AShayem/BGR_NSL_FINAL/Simulation and Validation Document_Bandgap_Reference_BGR_v2.pdf

# Bandgap Reference (BGR)

# Team Members:

## Md Abu Shayem, Engineer II Faruk Al-Amin, Engineer I Fahim Tawfiq Khan, Engineer I Ebadur Rahman Khan, Team Lead

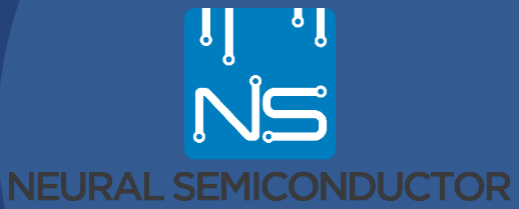
[picture p5: figure]

## Md. Shafiul Huda Eraz, Sr. Engineer

Analog Design, Neural Semiconductor Limited.

Bandgap Reference (BGR) | Md Abu Shayem | 2

# Design Specification

Parameter | Specification
VDD, VSS | 1.8V, 0V
Vref | 1.0V
Temp. Coefficient(Tc) | <30ppm/℃
Power | <200uW
Input Pin | 2
Output Pin | 1

Table 1: Design specification of the bandgap reference

# TB_BGR_Top

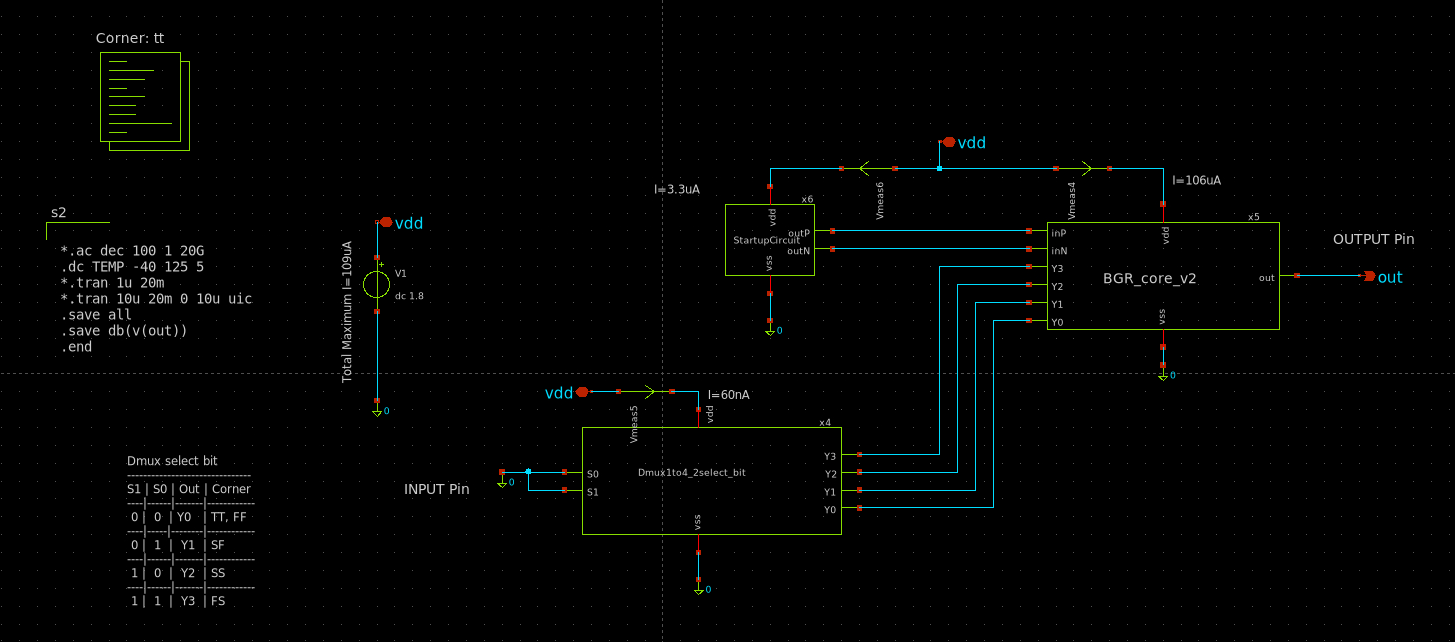
[picture p6: figure]

Figure 1: Block-level top testbench (TB_BGR_Top)

# TB_BGR_Top

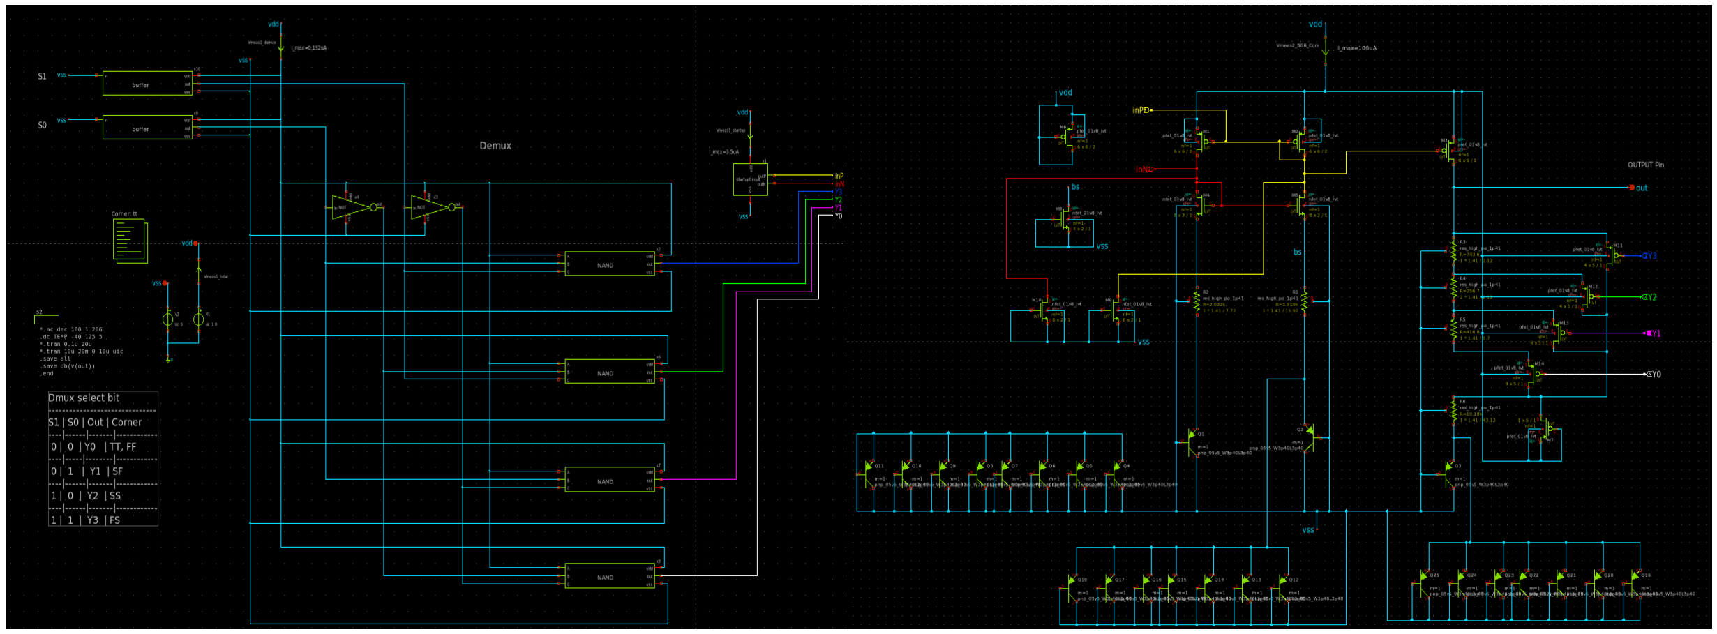
[picture p7: figure]

Note: Block level Testbench shows different Temperature coefficient (TC) result so another TB is created by making BGR core in device level.

Figure 2: Device-level top testbench (TB_BGR_Top) with the BGR core built from primitive devices

# Startup Circuit

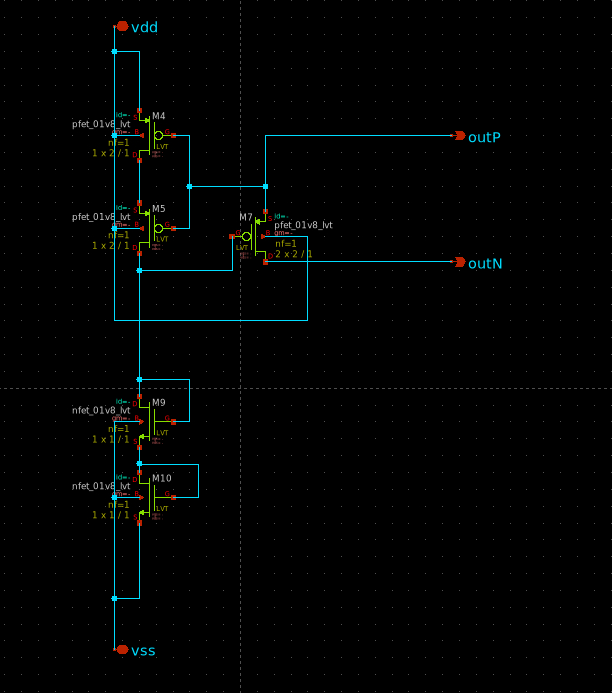
[picture p8: figure]

Figure 3: Startup circuit schematic

# BGR Core and Vref Branch

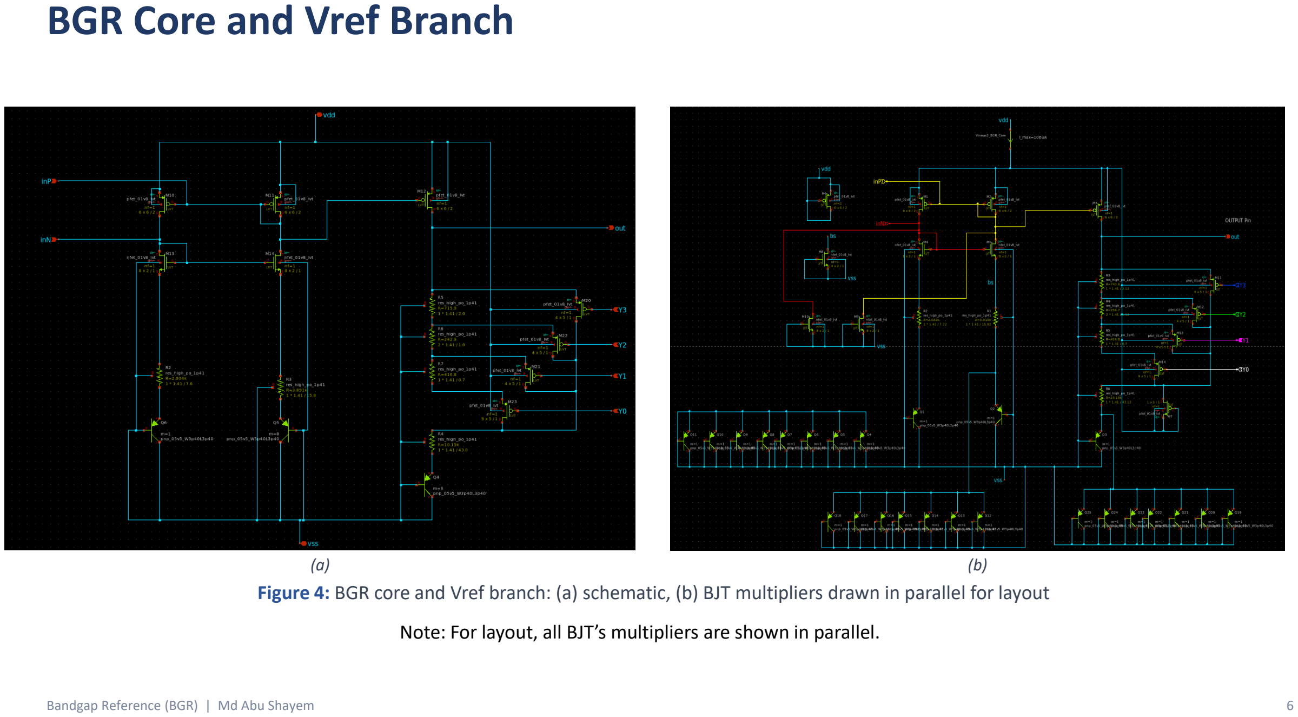
[picture p9: page 6]

Note: For layout, all BJT’s multipliers are shown in parallel.

(a) (b)
Figure 4: BGR core and Vref branch: (a) schematic, (b) BJT multipliers drawn in parallel for layout

# Dmux Schematic

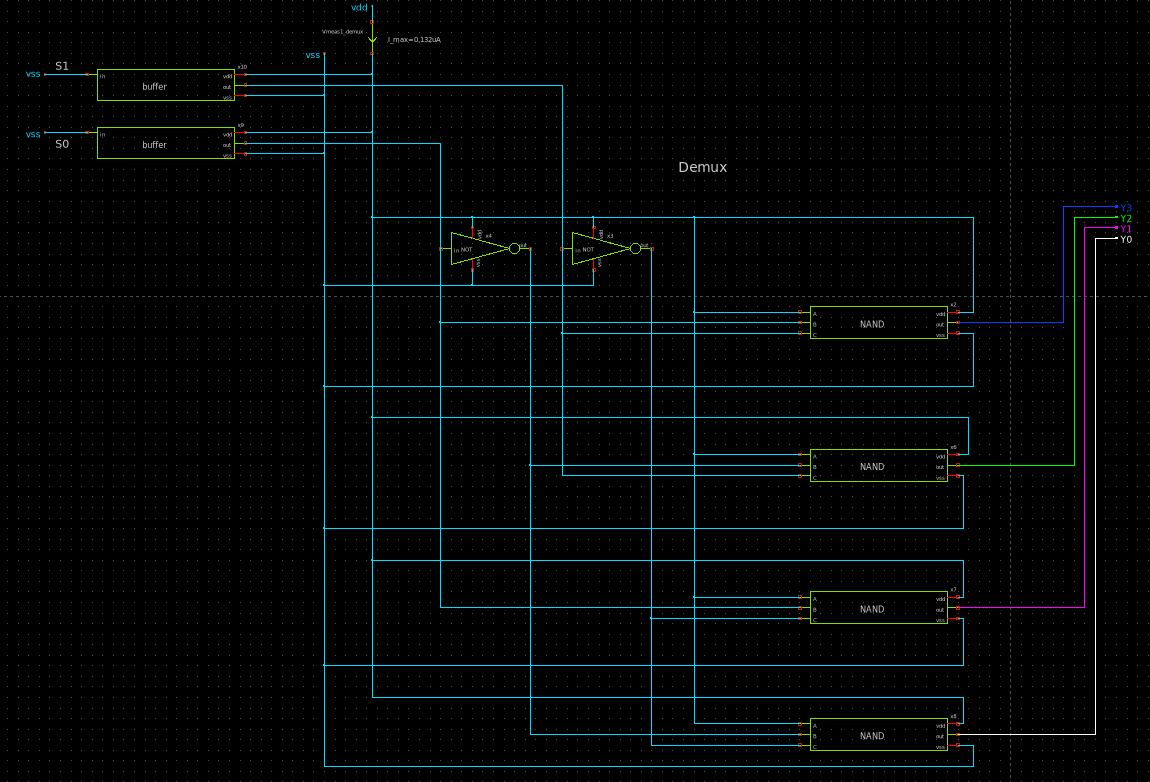
[picture p10: figure]

Figure 5: Dmux schematic

# Dmux select bit

S1 | S0 | Y3 | Y2 | Y1 | Y0 | Corner
0 | 0 | 1 | 1 | 1 | 0 | TT, FF
0 | 1 | 1 | 1 | 0 | 1 | SF
1 | 0 | 1 | 0 | 1 | 1 | SS
1 | 1 | 0 | 1 | 1 | 1 | FS

Table 2: Dmux select-bit settings and the corresponding process corners

# Corner: TT

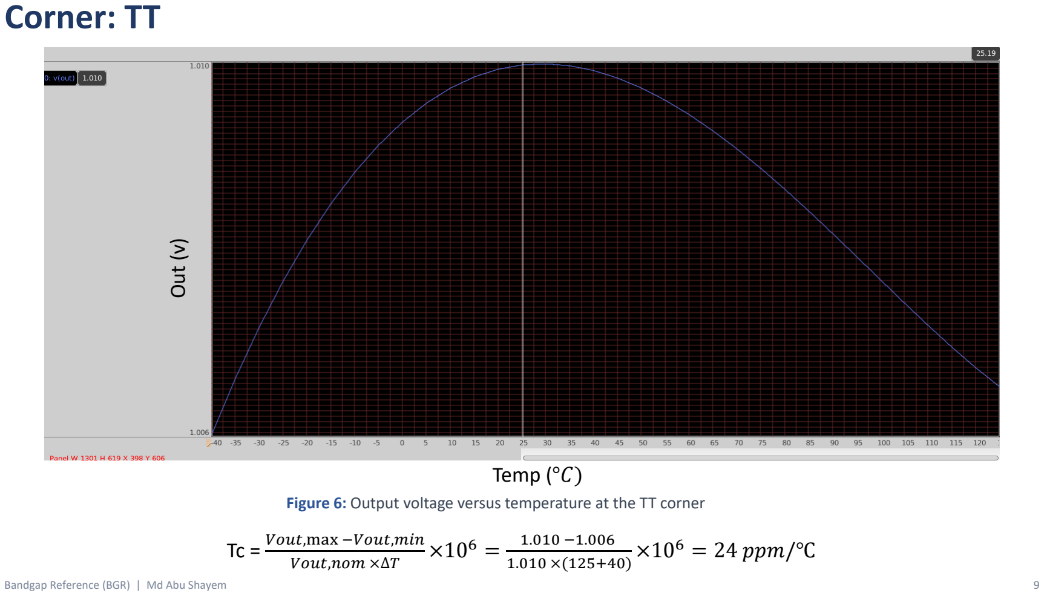
[picture p11: page 9]

### Out (v)

### Temp (°C)

Tc = Vout,max −Vout,min
Vout,nom ×∆T

×10⁶ =

1.010 −1.006
1.010 ×(125+40)

### ×10⁶ = 24 ppm/℃

Figure 6: Output voltage versus temperature at the TT corner

# Corner: FF

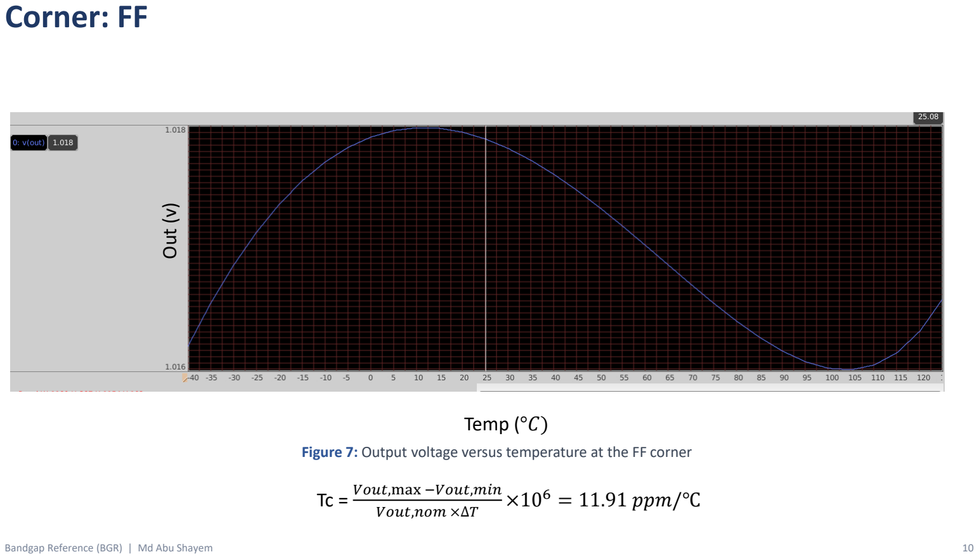
[picture p12: page 10]

### Out (v)

### Temp (°C)

Tc = Vout,max −Vout,min
Vout,nom ×∆T

### ×10⁶ = 11.91 ppm/℃

Figure 7: Output voltage versus temperature at the FF corner

# Corner: FS

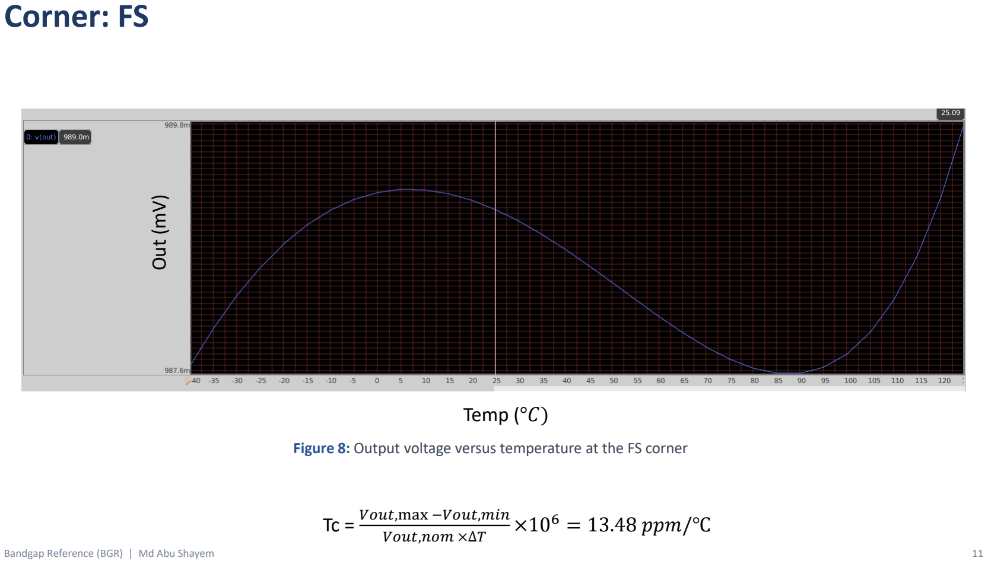
[picture p13: page 11]

### Out (mV)

### Temp (°C)

Tc = Vout,max −Vout,min
Vout,nom ×∆T

### ×10⁶ = 13.48 ppm/℃

Figure 8: Output voltage versus temperature at the FS corner

# Corner: SF

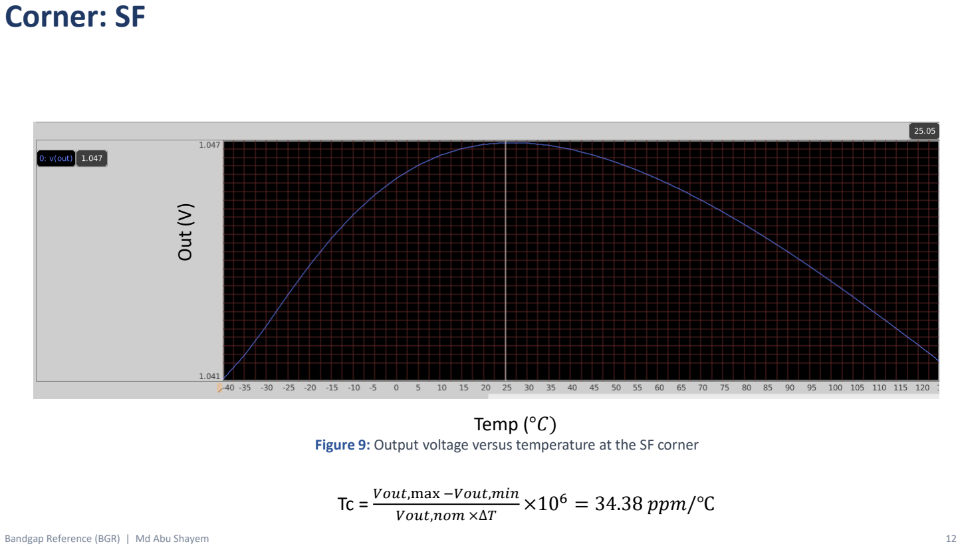
[picture p14: page 12]

### Out (V)

### Temp (°C)

Tc = Vout,max −Vout,min
Vout,nom ×∆T

### ×10⁶ = 34.38 ppm/℃

Figure 9: Output voltage versus temperature at the SF corner

# Corner: SS

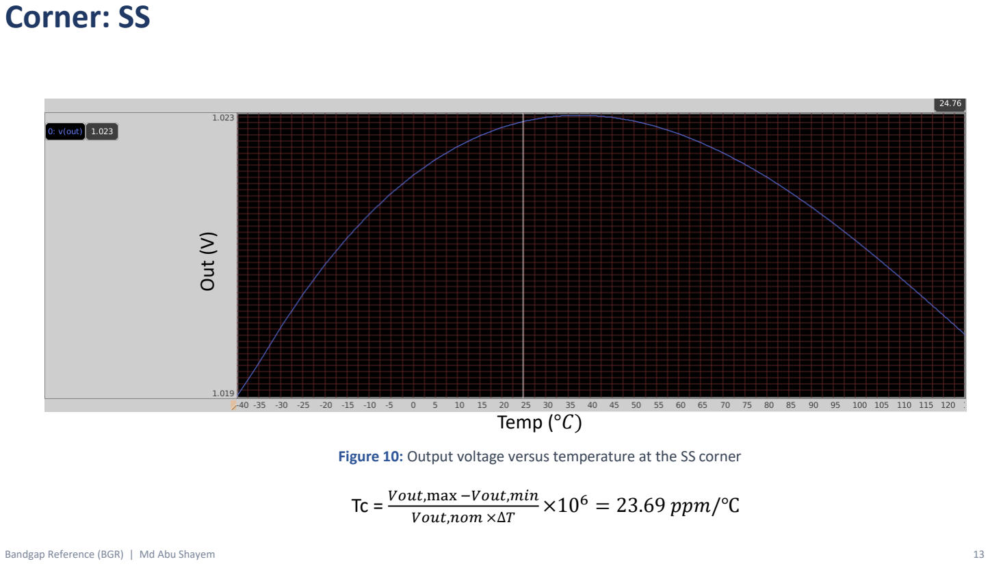
[picture p15: page 13]

### Out (V)

### Temp (°C)

Tc = Vout,max −Vout,min
Vout,nom ×∆T

### ×10⁶ = 23.69 ppm/℃

Figure 10: Output voltage versus temperature at the SS corner

# TB_Stability

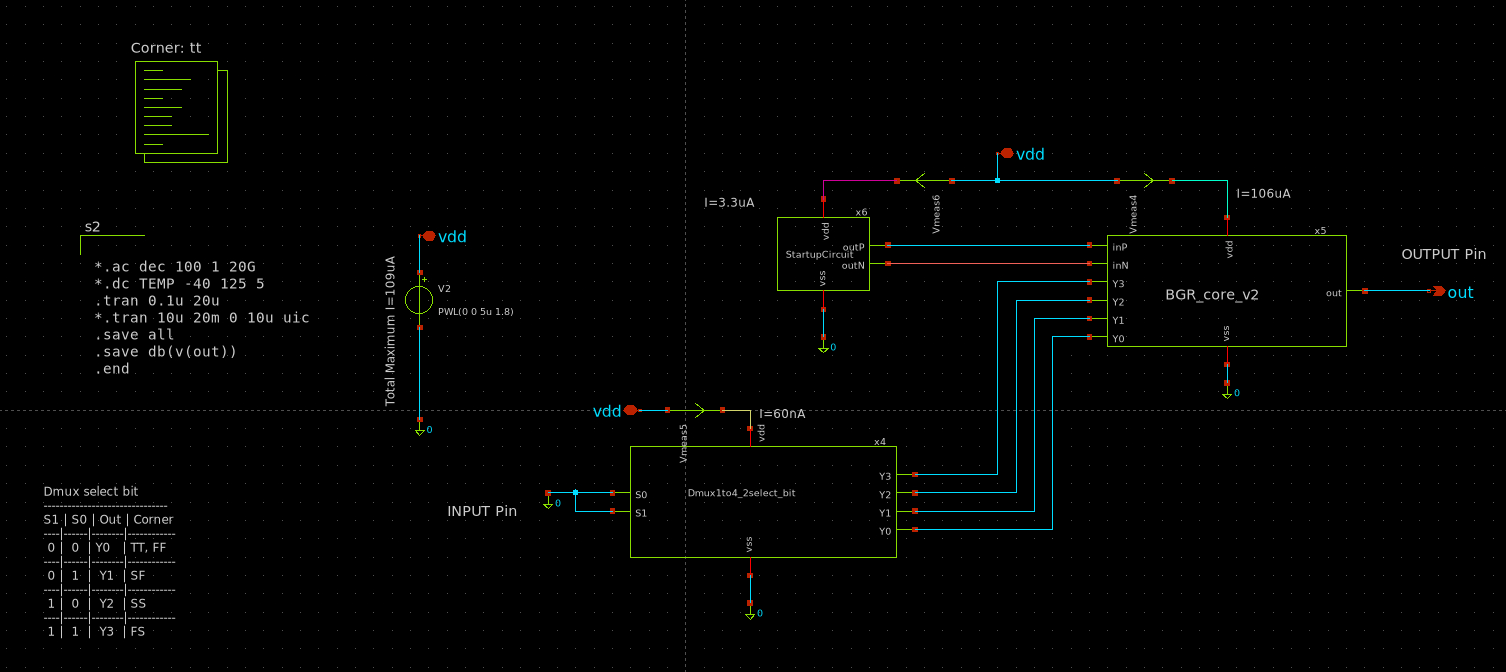
[picture p16: figure]

Figure 11: Stability testbench (TB_Stability)

# Stability_5us Ramp

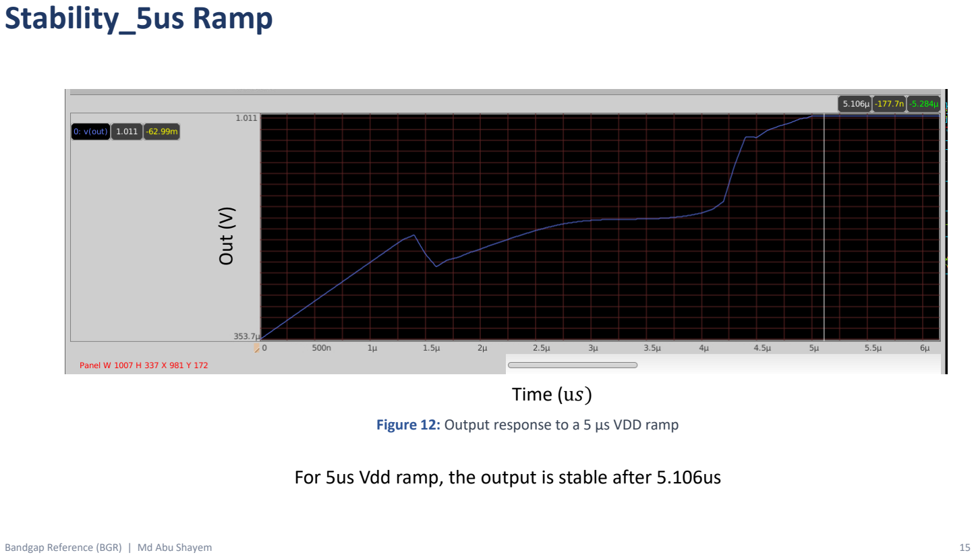
[picture p17: page 15]

### For 5us Vdd ramp, the output is stable after 5.106us

Figure 12: Output response to a 5 µs VDD ramp

### Out (V)

### Time (us)

# Stability_1us Ramp

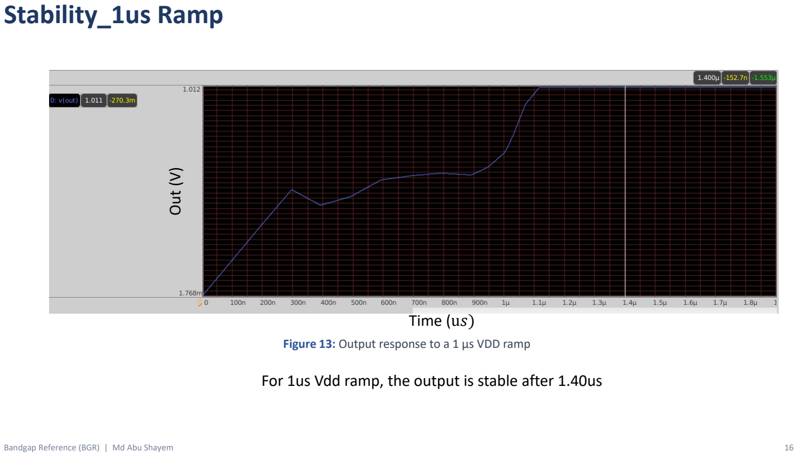
[picture p18: page 16]

### For 1us Vdd ramp, the output is stable after 1.40us

### Out (V)

### Time (us)

Figure 13: Output response to a 1 µs VDD ramp

# TB_PSRR

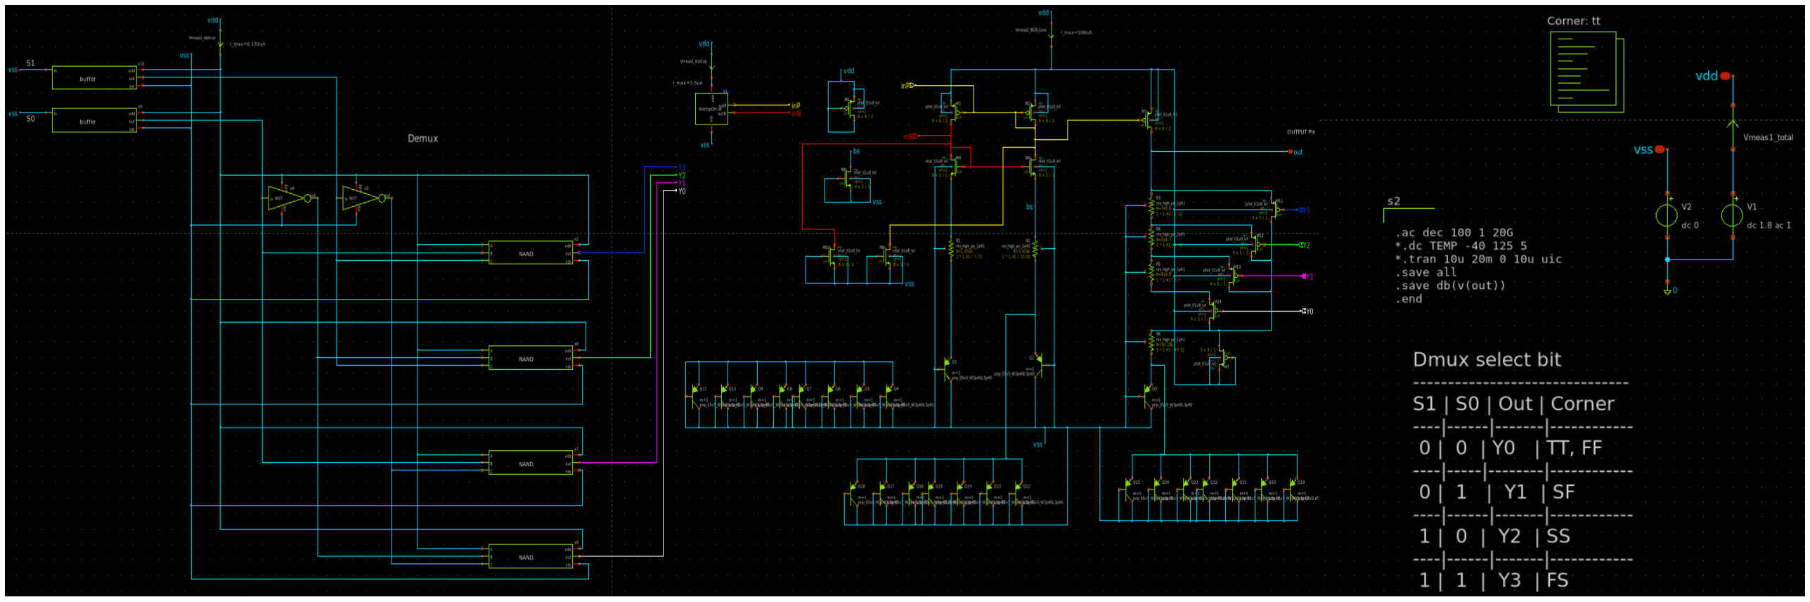
[picture p19: figure]

Figure 14: PSRR testbench (TB_PSRR)

# PSRR

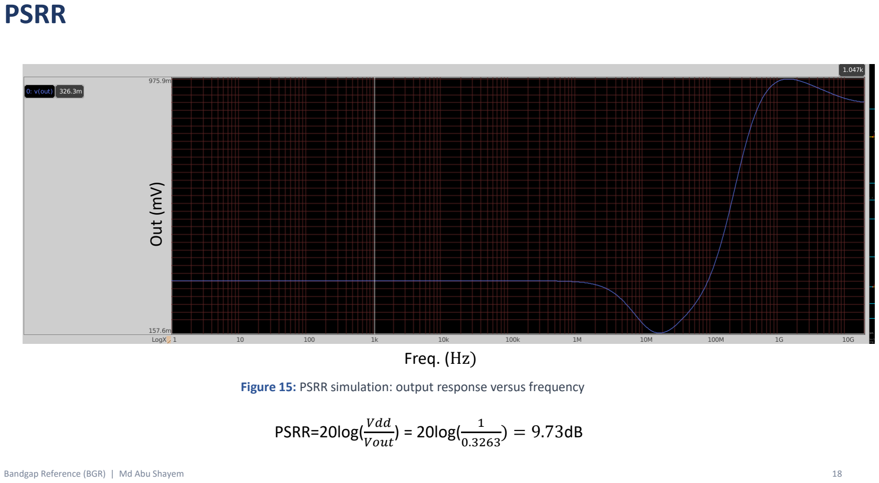
[picture p20: page 18]

### PSRR=20log( Vdd

Vout

### ) = 20log( 1

0.3263

) = 9.73dB

Figure 15: PSRR simulation: output response versus frequency

### Out (mV)

### Freq. (Hz)

# Key Results at Different Corners

Corner | Schematic | Post-layout (PEX)
(ppm/°C) Tc | Trim R6 (Ω) | Vout @ 27°C (V) | Power (µW) | S1 (V) | S0 (V) | Tc (ppm/°C) | Vout @ 27°C (V) | PSRR @ 1 kHz (dB) | Power (µW)
TT | 24 | 11.526k | 1.010 | 192.96 | 1.8 | 0 | 26.6 | 1.0213 | 9.47 | 193.72
FF | 11.91 | 11.526k | 1.018 | 198.36 | 1.8 | 0 | 21.4 | 1.0241 | 9.54 | 199.89
SS | 23.69 | 10.866k | 1.023 | 187.56 | 1.8 | 0 | 32.5 | 1.0185 | 8.99 | 188.11
FS | 13.48 | 10.18k | 0.9890 | 197.28 | 1.8 | 1.8 | 25.3 | 0.9887 | 7.66 | 199.20
SF | 34.73 | 11.109k | 0.9985 | 188.82 | 0 | 1.8 | 25.3 | 1.0407 | 11.19 | 189.57

R6_trim base is 10.18 kΩ; Rds of each switch MOS is added in series with each selection. S1/S0: 1.8 V = logic 1, 0 V = logic 0.

Table 3: Key results at different corners: schematic vs. post-layout (PEX)

# LVS Verification

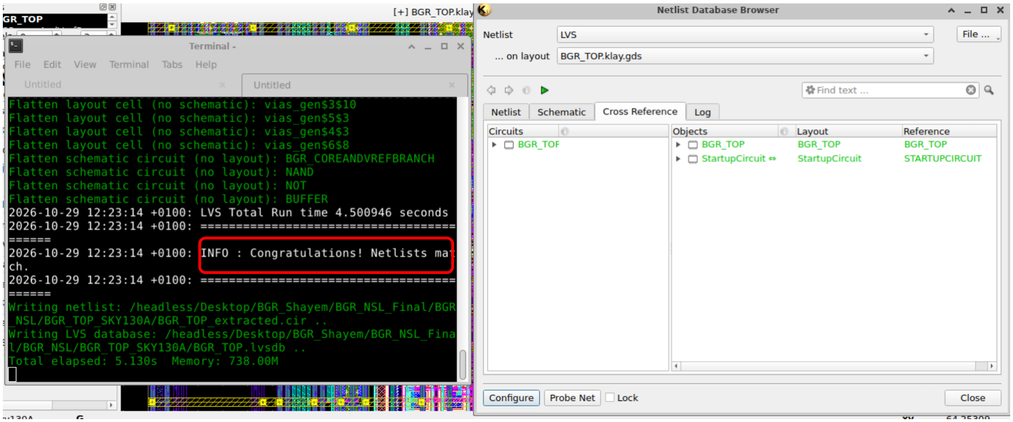
[picture p21: figure]

Figure 16: LVS verification result

# DRC Verification

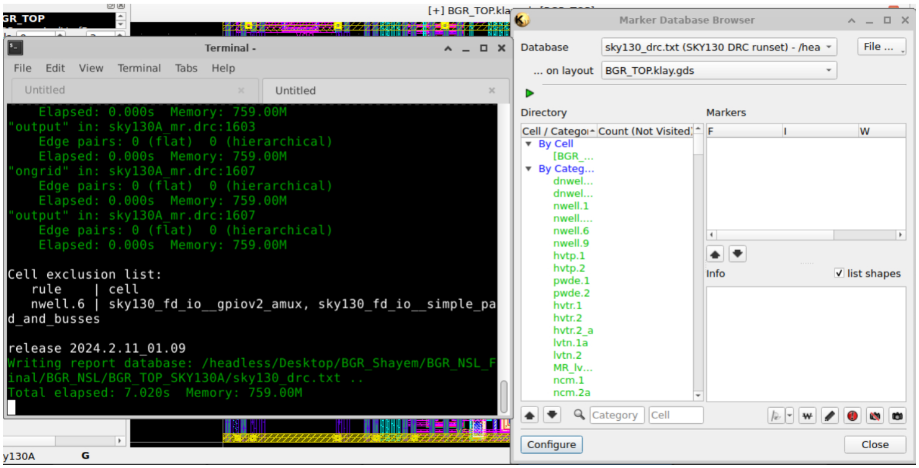
[picture p22: figure]

Figure 17: DRC verification result

# Top Level Layout

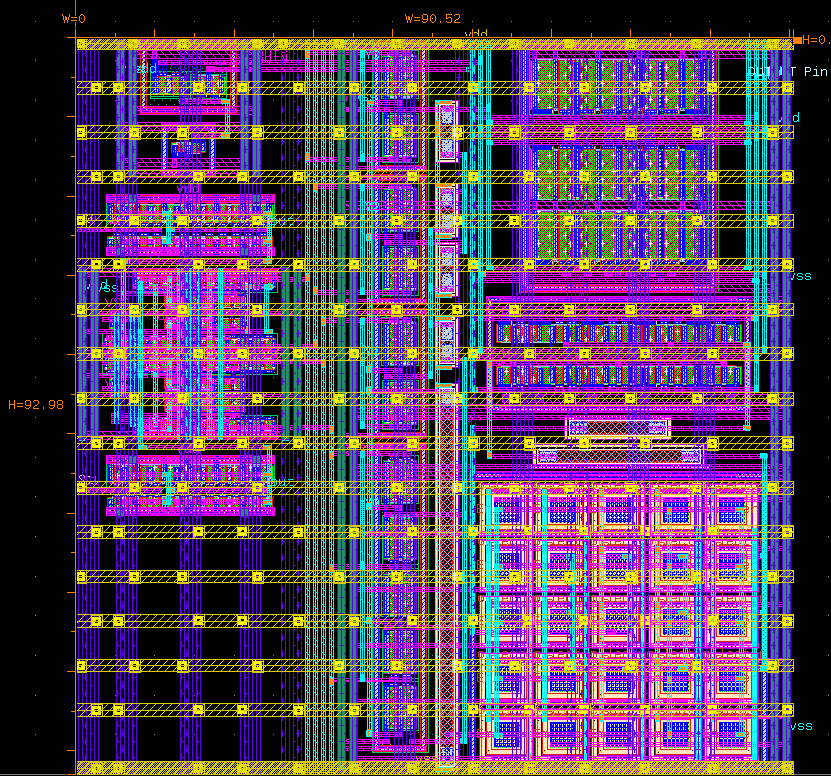
[picture p23: figure]

Figure 18: Top Level Layout with area 92.98 um X 90.52 um

# Access The Testbench to Reproduce

❑ Download the file from GitHub or go to the folder “BGR_NSL/BGR_TOP_SKY130A“ and find “BGR_TOP.sch” and BGR_TOP.klay.gds for LVS and DRC.

❑ For Schematic simulation, find “TB_BGR_TOP.sch” and change the select bit as shown in the TB or Demux select bits (Table 2) shown earlier in this document. Testbench for PSRR and Stability also be found as “TB_BGR_TOP_PSRR.sch” and “TB_BGR_TOP_Stability.sch”, respectively.

### ❑ GitHub Link: https://github.com/AShayem/BGR_NSL_FINAL.git

# SKY130 PDK Schematic and Layout Mismatch

- Resistance shows in the schematic and effective resistivity is different.

# Effective resistance in schematic is measured by R=VR/IR - In layout, effective resistance is around 30 ohms higher than schematic’s

effective resistance.

# - In layout, 0.12um is added by default, so 0.12um should be adjusted in

schematic to resolve LVS.

*Effective resistance in layout is calculated after PEX.
