AShayem/BGR_NSL_FINAL/BGR_NSL/BGR_TOP_SKY130A/results/psrr_summary.csv

S1_V | S0_V | corner | PSRR_1Hz_dB | PSRR_1kHz_dB | PSRR_1MHz_dB
0 | 0 | tt | 9.22 | 9.20 | 9.28
0 | 0 | ss | 8.78 | 8.78 | 8.88
0 | 0 | ff | 9.31 | 9.29 | 9.44
0 | 0 | sf | 11.27 | 11.27 | 11.41
0 | 0 | fs | 6.82 | 6.81 | 6.94
0 | 1.8 | tt | 9.63 | 9.62 | 9.74
0 | 1.8 | ss | 8.81 | 8.81 | 8.96
0 | 1.8 | ff | 9.37 | 9.36 | 9.53
0 | 1.8 | sf | 11.18 | 11.19 | 11.43
0 | 1.8 | fs | 6.92 | 6.91 | 7.05
1.8 | 0 | tt | 9.49 | 9.47 | 9.59
1.8 | 0 | ss | 8.99 | 8.99 | 9.14
1.8 | 0 | ff | 9.55 | 9.54 | 9.72
1.8 | 0 | sf | 11.36 | 11.37 | 11.61
1.8 | 0 | fs | 7.10 | 7.08 | 7.23
1.8 | 1.8 | tt | 9.97 | 9.95 | 10.08
1.8 | 1.8 | ss | 9.51 | 9.51 | 9.68
1.8 | 1.8 | ff | 10.08 | 10.07 | 10.25
1.8 | 1.8 | sf | 11.88 | 11.89 | 12.16
1.8 | 1.8 | fs | 7.67 | 7.66 | 7.81
