AShayem/BGR_NSL_FINAL/BGR_NSL/BGR_TOP_SKY130A/results/summary_tc_below_limit.csv

S1_V | S0_V | corner | TC_ppm_per_C | Vout_27C_V | PSRR_1kHz_dB
1.8 | 0 | ff | 21.4 | 1.02412 | 9.54
0 | 0 | ff | 22.0 | 1.02165 | 9.29
0 | 1.8 | sf | 25.3 | 1.04067 | 11.19
1.8 | 1.8 | fs | 25.3 | 0.98869 | 7.66
1.8 | 0 | tt | 26.6 | 1.02127 | 9.47
1.8 | 0 | ss | 32.5 | 1.01845 | 8.99
