AShayem/BGR_NSL_FINAL/BGR_NSL/BGR_TOP_SKY130A/results/tc_summary.csv

S1_V | S0_V | corner | Vout_27C_V | span_mV | TC_ppm_per_C
0 | 0 | tt | 1.01494 | 8.683 | 52.0
0 | 0 | ss | 1.00633 | 8.165 | 49.3
0 | 0 | ff | 1.02165 | 3.700 | 22.0
0 | 0 | sf | 1.01909 | 16.852 | 100.5
0 | 0 | fs | 1.00464 | 17.745 | 107.0
0 | 1.8 | tt | 1.02772 | 6.978 | 41.2
0 | 1.8 | ss | 1.02455 | 8.829 | 52.3
0 | 1.8 | ff | 1.03078 | 9.191 | 54.0
0 | 1.8 | sf | 1.04067 | 4.334 | 25.3
0 | 1.8 | fs | 1.01306 | 27.442 | 163.9
1.8 | 0 | tt | 1.02127 | 4.473 | 26.6
1.8 | 0 | ss | 1.01845 | 5.459 | 32.5
1.8 | 0 | ff | 1.02412 | 3.612 | 21.4
1.8 | 0 | sf | 1.03430 | 8.588 | 50.4
1.8 | 0 | fs | 1.00674 | 21.462 | 129.0
1.8 | 1.8 | tt | 1.00281 | 16.955 | 102.8
1.8 | 1.8 | ss | 1.00080 | 13.857 | 84.1
1.8 | 1.8 | ff | 1.00499 | 12.868 | 77.8
1.8 | 1.8 | sf | 1.01611 | 24.051 | 143.9
1.8 | 1.8 | fs | 0.98869 | 4.123 | 25.3
