AShayem/BGR_NSL_FINAL/BGR_NSL/BGR_TOP_SKY130A/results/psrr.png

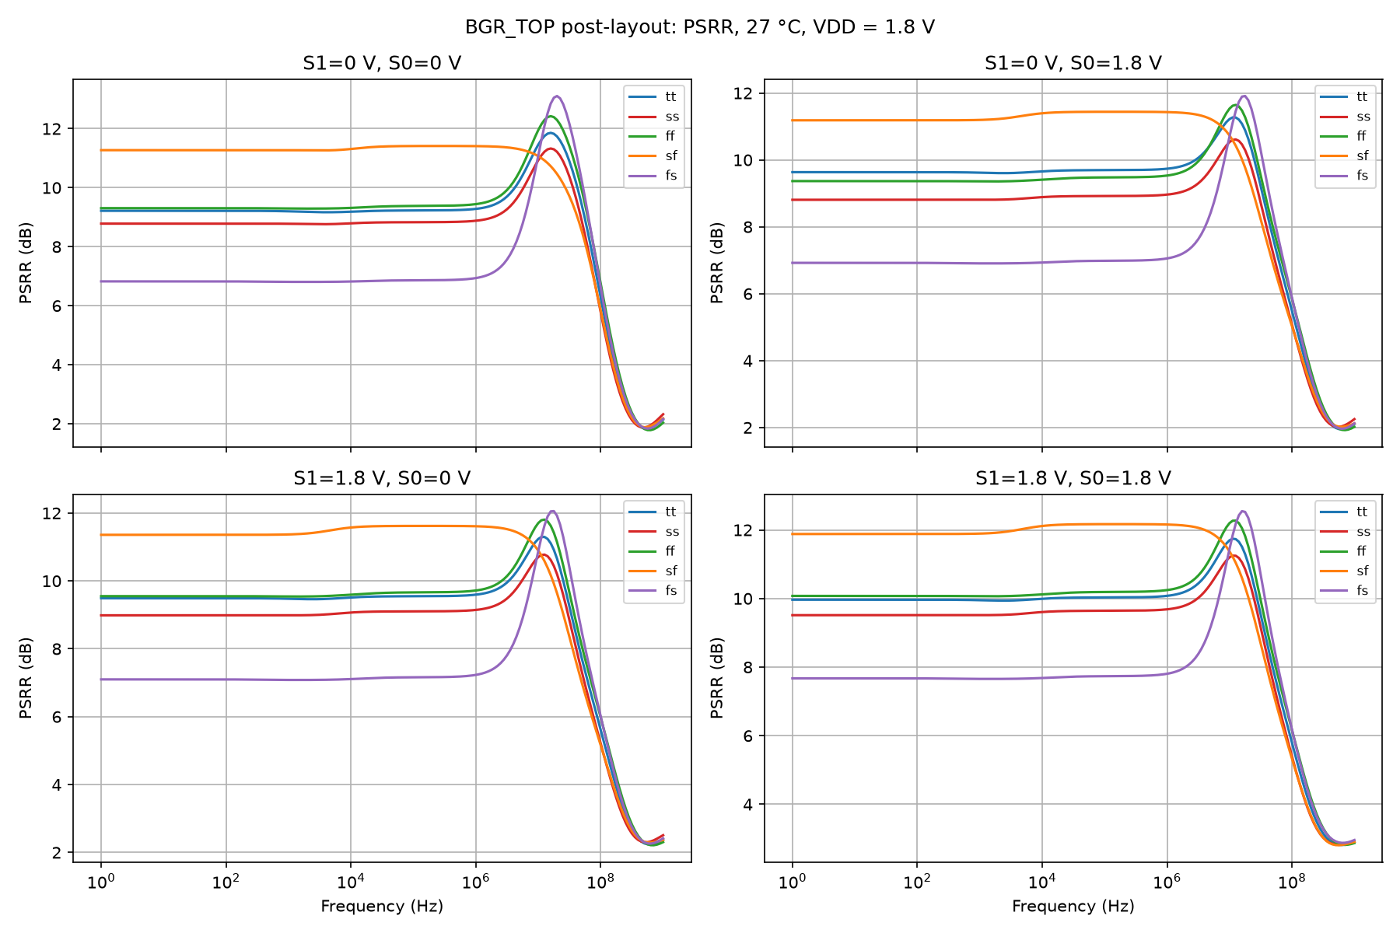
BGR_NSL/BGR_TOP_SKY130A/results/psrr.png
