AShayem/BGR_NSL_FINAL/BGR_NSL/BGR_TOP_SKY130A/results/vout_vs_temp.png

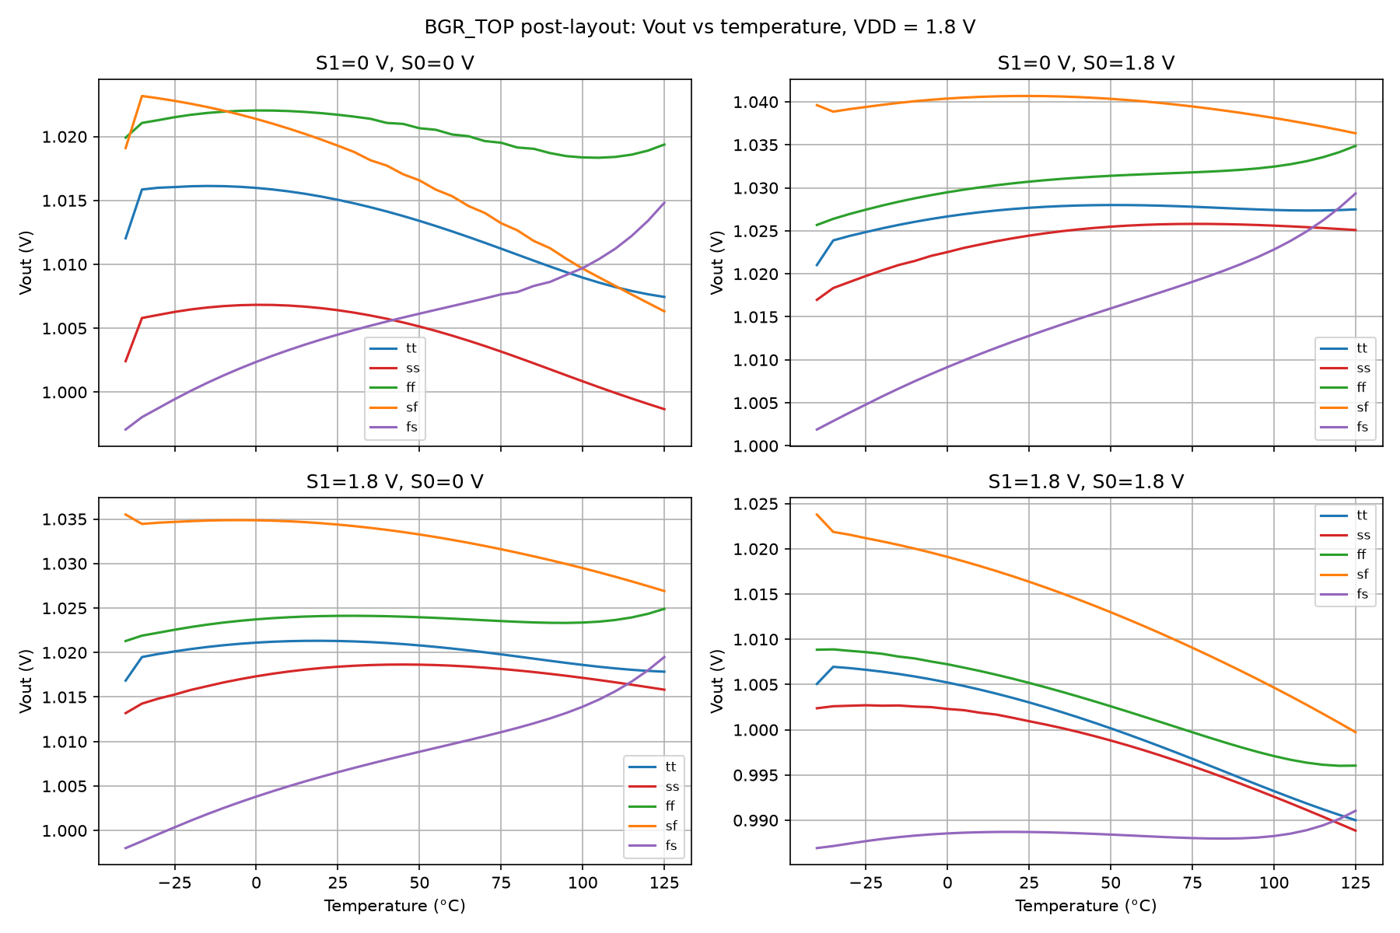
BGR_NSL/BGR_TOP_SKY130A/results/vout_vs_temp.png
