AShayem/BGR_NSL_FINAL/BGR_NSL/BGR_TOP_SKY130A/results/work/tb_tc_S1_0_S0_0_ff.spice

* PEX tc corner=ff S1=0 S0=0
.lib /foss/pdks/sky130A/libs.tech/combined/sky130.lib.spice ff
.include /headless/Desktop/BGR_Shayem/BGR_NSL_Final/BGR_NSL/BGR_TOP_SKY130A/BGR_TOP_pex.spice
Vsup vdd 0 DC 1.8
Vgnd vss 0 DC 0
Vsel0 S0 0 DC 0
Vsel1 S1 0 DC 0
Xdut S0 S1 out vdd vss S1 BGR_TOP
.control
dc temp -40 125 5
wrdata /headless/Desktop/BGR_Shayem/BGR_NSL_Final/BGR_NSL/BGR_TOP_SKY130A/results/work/tc_S1_0_S0_0_ff.txt v(out)
.endc
.end
